andrewvh4/Spot_Welder_Hardware/README.md

# Spot_Welder_Hardware
A Design for a low-cost spot welder used in electronics assembly
