andrewvh4/Spot_Welder_Hardware/SpotWelder_Hardware/Spot_Welder_Hardware.kicad_pcb

## KiCad design SpotWelder_Hardware/Spot_Welder_Hardware.kicad_pcb (2020-05-26)

Schematic: Spot_Welder_Hardware.sch, Spot Welder Hardware

Parts:
BZ1: Buzzer; BUZZER_SMI_1324_TW_5V_2_R; Part Number 668-1336-1-ND
C1, C2, C3, C4, C5, C6, C8, C9, C10, C12, C13, C14, C16, C17, C18, C20, C21, C22, C25, C26, C27, C29, C30, C31, C33, C34, C35, C36, C37, C38, C45: 47mF; CP_Radial_D30.0mm_P10.00mm_SnapIn; Part Number 565-2620-ND
C7, C11, C15, C19, C23, C24, C28, C32: C; C_0805_HandSoldering
C39, C40, C46, C47, C48: .1uF; C_0603_HandSoldering
C41, C42: 22pF; C_0603_HandSoldering
C43, C44: 10uF; C_0603_HandSoldering
Conn1, Conn2: BananaConnector; Banana_Jack_1Pin
Conn3: AndersonPP; Anderson_2_Horisontal_Side_by_Side
Conn4: Molex_SL_3; MOLEX_SL_3_Horizontal
D1: 5V; LED_0603_HandSoldering
D2: Pulse; LED_0603_HandSoldering
D3: 7.5V; LED_0603_HandSoldering
D4: Ext Trigger; LED_0603_HandSoldering
D5: 10V; LED_0603_HandSoldering
D6: Logic; LED_0603_HandSoldering
D7: 12.5V; LED_0603_HandSoldering
D8, D9: D_Schottky; D_0603_1608Metric_Pad1.05x0.95mm_HandSolder
D10: 14V; D_SOD-123; Part Number BZT52C15-FDICT-ND
D11: Over Voltage; LED_0603_HandSoldering
D12: 20V; D_SOD-123; Part Number B0520LW-FDICT-ND
D13: D; TO-220-2_Vertical; Part Number MUR1560GOS-ND
D14, D15, D16, D19: D; TO-220-2_Vertical
D17: TX; LED_0603_HandSoldering
D18: RX; LED_0603_HandSoldering
D20: FTDI PWR; LED_0603_HandSoldering
J1: Mini USB; MiniUSB_SMT; Part Number 151-1206-1-ND
J2: Conn_01x03_Male; Pin_Header_Straight_1x03_Pitch2.54mm
L1: Ferrite_Bead; L_0603_HandSoldering; Part Number 732-1593-1-ND
L2, L3, L4, L5, L6, L7, L8, L9, L10: Ferrite_Bead; L_0603_HandSoldering
Q1: Q_NMOS_GSD; SOT-323_SC-70_Handsoldering; Part Number 2N7002PW
Q2: MBT3904; SOT-23
Q3, Q4, Q5, Q6, Q7, Q8, Q9, Q10, Q11, Q12, Q13: Q_NMOS_GDS; TO-220-3_Vertical; Part Number PSMN1R1
R1, R3, R5, R6, R7, R8, R9: 500; R_0603_HandSoldering
R2, R17, R22, R27, R33: 10k; R_0603_HandSoldering
R4, R24, R25: 1k; R_0603_HandSoldering
R10, R15: 3000; R_0603_HandSoldering
R11, R16, R39, R41, R42: 1000; R_0603_HandSoldering
R12, R13, R14: 5; R_Axial_Power_L25.0mm_W6.4mm_P30.48mm; Part Number YAG1224CT-ND
R18, R20, R40: 10K; R_0603_HandSoldering
R19: 1K; R_0603_HandSoldering
R21: 250; R_0603_HandSoldering
R23, R26, R28, R29, R30, R31, R32, R34, R36, R38: 10; R_0603_HandSoldering
R35, R37: 330; R_0603_HandSoldering
SW1, SW4: SW_Push; SPST_Pushbutton; Part Number CKN9088CT-ND
SW2: SW_SPDT; SPDT_Switch; Part Number CKN9628-ND
SW3: Lead Voltage Trigger; SPST_DIP_Switch; Part Number CKN10358-ND
U1: OKI; OKI_Horisontal
U2: ATMEGA328P; DIP-28_W7.62mm; Part Number ED3050-5-ND
U3, U5: FAN3122TMXCT-ND; SOIC-8_3.9x4.9mm_Pitch1.27mm
U4: FT232RL; SSOP-28_5.3x10.2mm_Pitch0.65mm
Y1: Crystal; Crystal_SMD_HC49-SD_HandSoldering; Part Number XC1592CT-ND

Connections:
5V_Ind: R1.2, U2.15 ((PCINT1/OC1A)PB1)
7.5V_Ind: R5.2, U2.16 ((PCINT2/OC1B/~SS~)PB2)
10V_Ind: R7.2, U2.17 ((PCINT3/OC2A/MOSI)PB3)
12.5V_Ind: R9.2, U2.18 ((PCINT4/MISO)PB4)
+5V: BZ1.1 (-), C39.1, C44.2, Conn4.1, D8.1 (K), D9.1 (K), R8.2, R17.1, SW1.1, SW3.1 (A), U1.3 (Vo), U2.7 (VCC), U2.20 (AVCC), U3.3 (EN), U5.3 (EN)
/Vin: C43.1, C45.1, D12.1 (K), R21.1, U1.1 (Vi)
Buzzer: R2.1, R4.1, U2.6 ((PCINT20/XCK/T0)PD4)
Conn_GND: Conn2.1, Conn3.1 (GND), SW2.3 (C)
D+: J1.3, U4.15 (USBDP)
D-: J1.2, U4.16 (USBDM)
DTR: C48.1, J2.3, U4.2 (DTR#)
Ext_Trigger: Conn4.2, R6.2, U2.12 ((PCINT22/OC0A/AIN0)PD6)
GND: C1.2, C2.2, C3.2, C4.2, C5.2, C6.2, C7.2, C8.2, C9.2, C10.2, C11.2, C12.2, C13.2, C14.2, C15.2, C16.2, C17.2, C18.2, C19.2, C20.2, C21.2, C22.2, C23.2, C24.2, C25.2, C26.2, C27.2, C28.2, C29.2, C30.2, C31.2, C32.2, C33.2, C34.2, C35.2, C36.2, C37.2, C38.2, C39.2, C40.2, C41.2, C42.2, C43.2, C44.1, C45.2, C46.2, C47.1, Conn4.3, D1.1 (K), D2.1 (K), D3.1 (K), D4.1 (K), D5.1 (K), D6.1 (K), D7.1 (K), D20.1 (K), J1.5, Q1.2 (S), Q3.2 (D), Q4.3 (S), Q5.3 (S), Q6.3 (S), Q7.3 (S), Q8.3 (S), Q9.3 (S), Q10.3 (S), Q11.3 (S), Q12.3 (S), Q13.3 (S), R2.2, R11.2, R16.2, R21.2, R22.2, R27.2, R33.2, R41.1, R42.1, SW4.1, U1.2 (GND), U2.8 (GND), U2.22 (GND), U3.4 (GND), U3.5 (GND), U4.7 (GND), U4.18 (GND), U4.21 (GND), U4.25 (AGND), U4.26 (TEST), U5.4 (GND), U5.5 (GND)
IC_RX: J2.2, R24.1, U4.1 (TXD)
IC_TX: J2.1, R25.1, U4.5 (RXD)
Lead_Sense: D8.2 (A), R10.1, R11.1, U2.24 ((PCINT9/ADC1)PC1)
Lead_Voltage_Trigger: R42.2, SW3.2 (B), U2.13 ((PCINT23/AIN1)PD7)
unnamed: BZ1.2 (+), Q1.3 (D)
unnamed: C40.1, U2.21 (AREF)
unnamed: C41.1, U2.9 ((PCINT6/XTAL1/TOSC1)PB6), Y1.1
unnamed: C42.1, U2.10 ((PCINT7/XTAL2/TOSC2)PB7), Y1.2
unnamed: C46.1, U4.17 (3V3_Out)
unnamed: D1.2 (A), R1.1
unnamed: D2.2 (A), R3.1
unnamed: D3.2 (A), R5.1
unnamed: D4.2 (A), R6.1
unnamed: D5.2 (A), R7.1
unnamed: D6.2 (A), R8.1
unnamed: D7.2 (A), R9.1
unnamed: D10.2 (A), R19.2
unnamed: D11.1 (K), R40.2
unnamed: D17.1 (K), U4.22 (CBUS1)
unnamed: D17.2 (A), R35.2
unnamed: D18.1 (K), U4.23 (CBUS0)
unnamed: D18.2 (A), R37.2
unnamed: D20.2 (A), R39.2
unnamed: L1.1, Q4.1 (G)
unnamed: L1.2, R23.1
unnamed: L2.1, Q5.1 (G)
unnamed: L2.2, R26.1
unnamed: L3.1, Q6.1 (G)
unnamed: L3.2, R28.1
unnamed: L4.1, Q7.1 (G)
unnamed: L4.2, R29.1
unnamed: L5.1, Q8.1 (G)
unnamed: L5.2, R30.1
unnamed: L6.1, Q9.1 (G)
unnamed: L6.2, R31.1
unnamed: L7.1, Q10.1 (G)
unnamed: L7.2, R32.1
unnamed: L8.1, Q11.1 (G)
unnamed: L8.2, R34.1
unnamed: L9.1, Q12.1 (G)
unnamed: L9.2, R36.1
unnamed: L10.1, Q13.1 (G)
unnamed: L10.2, R38.1
unnamed: Q1.1 (G), R4.2
unnamed: Q2.1 (B), R19.1, R20.1
unnamed: Q2.3 (C), Q3.1 (G), R18.1, R40.1
unnamed: R12.1, R13.2
unnamed: R12.2, SW2.1 (A)
unnamed: R13.1, R14.2
unnamed: R23.2, R26.2, R28.2, R29.2, R30.2, U3.6 (Out), U3.7 (Out)
unnamed: R24.2, U2.2 ((PCINT16/RXD)PD0)
unnamed: R25.2, U2.3 ((PCINT17/TXD)PD1)
unnamed: R31.2, R32.2, R34.2, R36.2, R38.2, U5.6 (Out), U5.7 (Out)
Power_GND: Q2.2 (E), Q3.3 (S), R20.2, SW2.2 (B)
Pulse_Out: R3.2, R27.1, R33.1, R41.2, SW1.2, U2.11 ((PCINT21/OC0B/T1)PD5), U3.2 (IN), U5.2 (IN)
Reset: C48.2, R17.2, SW4.2, U2.1 ((PCINT14/~RESET~)PC6)
USB+5V: C47.2, J1.1, R35.1, R37.1, R39.1, U4.4 (VCCIO), U4.19 (RESET#), U4.20 (VCC)
V+: C1.1, C2.1, C3.1, C4.1, C5.1, C6.1, C7.1, C8.1, C9.1, C10.1, C11.1, C12.1, C13.1, C14.1, C15.1, C16.1, C17.1, C18.1, C19.1, C20.1, C21.1, C22.1, C23.1, C24.1, C25.1, C26.1, C27.1, C28.1, C29.1, C30.1, C31.1, C32.1, C33.1, C34.1, C35.1, C36.1, C37.1, C38.1, Conn1.1, Conn3.2 (V+Log), D10.1 (K), D11.2 (A), D12.2 (A), D13.1 (K), D14.1 (K), D15.1 (K), D16.1 (K), D19.1 (K), R14.1, R15.2, R18.2, U3.1 (VDD), U3.8 (VDD), U5.1 (VDD), U5.8 (VDD)
VS: D13.2 (A), D14.2 (A), D15.2 (A), D16.2 (A), D19.2 (A), Q4.2 (D), Q5.2 (D), Q6.2 (D), Q7.2 (D), Q8.2 (D), Q9.2 (D), Q10.2 (D), Q11.2 (D), Q12.2 (D), Q13.2 (D), R10.2, R22.1
V_Sense: D9.2 (A), R15.1, R16.1, U2.23 ((PCINT8/ADC0)PC0)

Notes on the sheet:
Main Capacitor Bank
External Connections
Power Input
External Trigger
Open Drain
Power Filtering
Indication
Microcontroller
FTDI
Capacitor Voltage Read
Voltage Indication
ToDo: Find capacitance
Lead Voltage Read
Trigger Override
Interface
Lead-Voltage Trigger
ADC 0
ADC 1
Used to toggle lead voltage trigger mode
D12
D11
D10
Serial Headers
USB
Logic Power
On/Off
Power
Trigger
Voltage Read
Over-Voltage Protection
30 parallel capacitors @4700uF and 14mOhm ESR yields 1.41F and .47mOhm ESR
Active Low
Safety Short VS to Ground
at 15Ohm and 1.4F, t = 10s 5t = 50s At 15V, each resistor will carry 5W

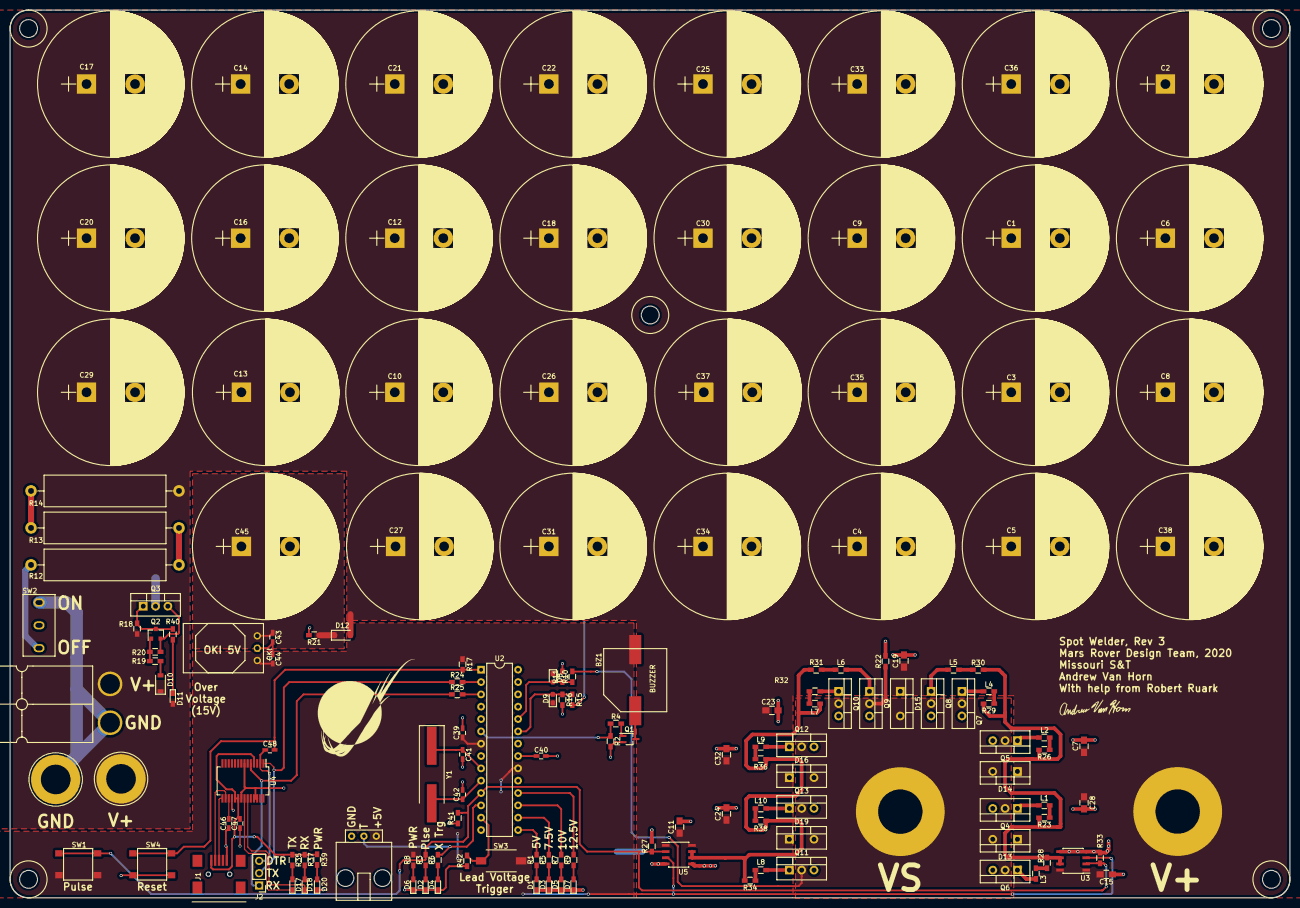
[picture p1: board Spot_Welder_Hardware.kicad_pcb from above]

Board: 2 copper layers, 263.7 x 182.9 mm, 150 parts (0 on the bottom side), 73 nets.
