andrewvh4/Spot_Welder_Hardware/(commit log)

2018-06-29 Rough Schematic
    Still need to double check component values before review.
    [Spot_Welder_Hardware.kicad_pcb, Spot_Welder_Hardware.sch]
2018-06-30 modified component values
    Final touchups before schematic review.
    [Spot_Welder_Hardware.sch]
2018-06-30 Added Buzzer circuitry
    [Spot_Welder_Hardware.sch]
2018-06-30 Added Buzzer Part number
    [Spot_Welder_Hardware.sch]
2018-06-30 Minor Formatting Tweaks
    [Spot_Welder_Hardware.sch]
2018-07-04 Added Voltage Limiting Circuitry and annotation
    [Spot_Welder_Hardware.sch]
2018-08-15 Finalized BOM
    [Spot_Welder_Hardware.kicad_pcb, Spot_Welder_Hardware.sch]
2018-09-24 Started board layout
    [Spot_Welder_Hardware-2018-09-24-16-50-00.sch, Spot_Welder_Hardware.kicad_pcb]
2018-09-25 High-lvel power placemet
    [Spot_Welder_Hardware.kicad_pcb, Spot_Welder_Hardware.sch]
2018-09-28 Placed components and routed all signal
    [Spot_Welder_Hardware.kicad_pcb, Spot_Welder_Hardware.sch]
2018-09-28 Moved around Components
    [Spot_Welder_Hardware.kicad_pcb]
2018-09-28 Created Polygons
    [Spot_Welder_Hardware.kicad_pcb]
2018-09-28 Finished Fill Zones and grounding
    [Spot_Welder_Hardware.kicad_pcb, _saved_Spot_Welder_Hardware.sch]
2018-09-28 re-routed 5V to Lead Voltage Trigger
    [Spot_Welder_Hardware.sch, _saved_Spot_Welder_Hardware.sch]
2018-09-29 Modified OverVoltage Protection LED
    [Spot_Welder_Hardware.sch]
2018-09-29 Added 6-32 Mounting Holes
    [Spot_Welder_Hardware.kicad_pcb]
2018-09-29 Fixed Vias on crystal caps
    [Spot_Welder_Hardware.kicad_pcb]
2018-09-29 Moved second gate driver closer to the ransistors
    [Spot_Welder_Hardware.kicad_pcb]
2018-09-29 Moved VS sense trace
    [Spot_Welder_Hardware.kicad_pcb]
2018-09-29 Swapped main MOSFETs to PSMN1R1-30PL
    [Spot_Welder_Hardware.sch]
2018-09-29 Modified Analog limiter circuit for analogue reads
    [Spot_Welder_Hardware.sch]
2018-09-29 Brke up ground plane for digital circuitry
    [Spot_Welder_Hardware.kicad_pcb]
2018-09-29 Changes Resistor To 1K
    [Spot_Welder_Hardware.sch]
2018-09-29 Changed Gate Driver Power to V+
    [Spot_Welder_Hardware.sch]
2018-09-29 Moved Gate Driver closer to MOSFETs
    [Spot_Welder_Hardware.kicad_pcb]
2018-09-29 Changed BJT
    [Spot_Welder_Hardware.sch]
2018-09-29 Frew new Traces for change in schematic
    [_saved_Spot_Welder_Hardware.sch]
2018-09-29 Finished Silkscreen
    [Spot_Welder_Hardware.kicad_pcb, _saved_Spot_Welder_Hardware.sch]
2018-09-29 Re-routed LED indications in ATMEGA
    [Spot_Welder_Hardware.sch, _saved_Spot_Welder_Hardware.sch]
2018-09-29 Updated BOM
    [Spot_Welder_Hardware.kicad_pcb]
2018-09-30 Fixed outline and mounting holes
    [Spot_Welder_Hardware.kicad_pcb]
2018-09-30 Replaced D8, D9 with Shottky Diode
    [Spot_Welder_Hardware.kicad_pcb, Spot_Welder_Hardware.sch]
2018-09-30 Moved around ground planes
    [Spot_Welder_Hardware.kicad_pcb, _saved_Spot_Welder_Hardware.sch]
2018-09-30 Routed Ground Plane
    [Spot_Welder_Hardware.kicad_pcb]
2018-09-30 Modified Schematic
    [Spot_Welder_Hardware.sch, _saved_Spot_Welder_Hardware.sch]
2018-09-30 Modified gitignore and added BOM
    [Spot_Welder_BOM.csv, Spot_Welder_Hardware.csv]
2018-10-01 Updated 6-32 Hole Size
    [Spot_Welder_Hardware.kicad_pcb]
2018-11-20 Mino changes from Assembly
    [Spot_Welder_Hardware-B.Cu.gbr, Spot_Welder_Hardware-B.Mask.gbr, Spot_Welder_Hardware-B.Paste.gbr, Spot_Welder_Hardware-B.SilkS.gbr, Spot_Welder_Hardware-Edge.Cuts.gbr, Spot_Welder_Hardware-F.Cu.gbr, Spot_Welder_Hardware-F.Mask.gbr, Spot_Welder_Hardware-F.Paste.gbr]
2018-11-21 Updated todo
    [Spot_Welder_Hardware.sch]
2018-11-21 Updated shematic libraries
    [Spot_Welder_Hardware.sch]
2018-11-21 Added pulldown Resistor to switches
    [Spot_Welder_Hardware.sch]
2018-11-21 Fixed Layout
    [Spot_Welder_Hardware.kicad_pcb, Spot_Welder_Hardware.sch]
2018-11-21 Fixed Layout Issues
    [Spot_Welder_Hardware.kicad_pcb]
2019-01-20 Added ToDo Notes
    [Spot_Welder_Hardware-B.Cu.gbr, Spot_Welder_Hardware-B.Mask.gbr, Spot_Welder_Hardware-B.Paste.gbr, Spot_Welder_Hardware-B.SilkS.gbr, Spot_Welder_Hardware-Edge.Cuts.gbr, Spot_Welder_Hardware-F.Cu.gbr, Spot_Welder_Hardware-F.Mask.gbr, Spot_Welder_Hardware-F.Paste.gbr]
2020-05-26 Cleaned repo structure and updated library mappings
    [Spot_Welder_BOM.csv, Spot_Welder_Hardware-2018-09-24-16-50-00.sch, Spot_Welder_Hardware.csv, Spot_Welder_Hardware.kicad_pcb, Spot_Welder_Hardware.sch]
2020-05-26 Changed OverV sense zener to 14V to provide better tolerance after testing.
    [Spot_Welder_BOM.csv, Spot_Welder_Hardware.sch]
2020-05-26 Added center support hole
    [Spot_Welder_Hardware.kicad_pcb]
2020-05-26 Inc version number and generated gerbs
    [Spot_Welder_Hardware-B.Cu.gbr, Spot_Welder_Hardware-B.Mask.gbr, Spot_Welder_Hardware-B.Paste.gbr, Spot_Welder_Hardware-B.SilkS.gbr, Spot_Welder_Hardware-Edge.Cuts.gbr, Spot_Welder_Hardware-F.Cu.gbr, Spot_Welder_Hardware-F.Mask.gbr, Spot_Welder_Hardware-F.Paste.gbr]
2020-05-26 Updated version number
    [Spot_Welder_Hardware.kicad_pcb]
2020-05-26 renumbered BOM
    [Spot_Welder_BOM.csv]
2020-05-26 Updated 0805 Cap Value
    [Spot_Welder_BOM.csv]
